Noseiden/Proyecto-SE/Hardware/Evidencia Fotográfica/Diseño PCB.png

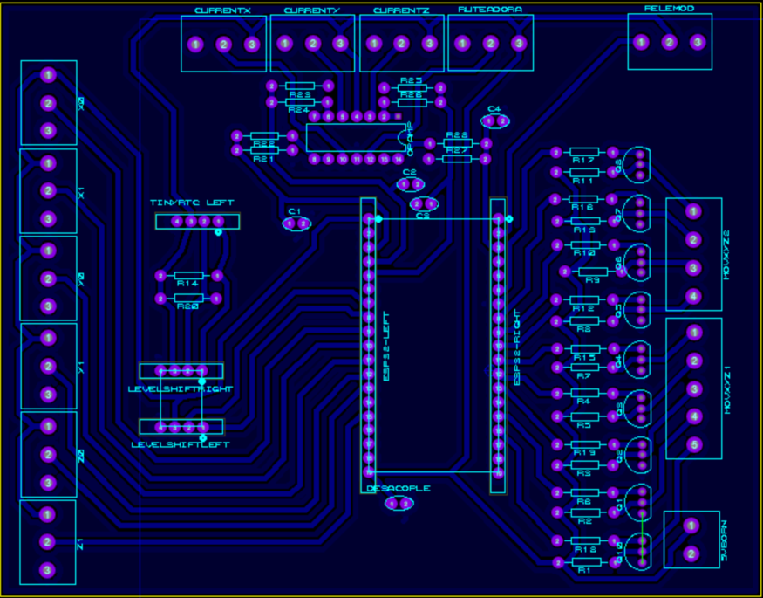
Hardware/Evidencia Fotográfica/Diseño PCB.png
