Noseiden/Proyecto-SE/Hardware/Evidencia Fotográfica/Conexiones en Gabinete.jpg

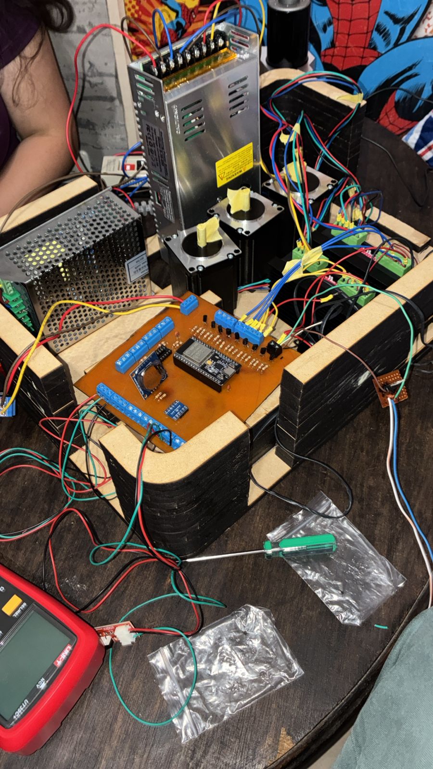
Hardware/Evidencia Fotográfica/Conexiones en Gabinete.jpg
