Noseiden/Proyecto-SE/Docs/DiagramaBloques.pdf

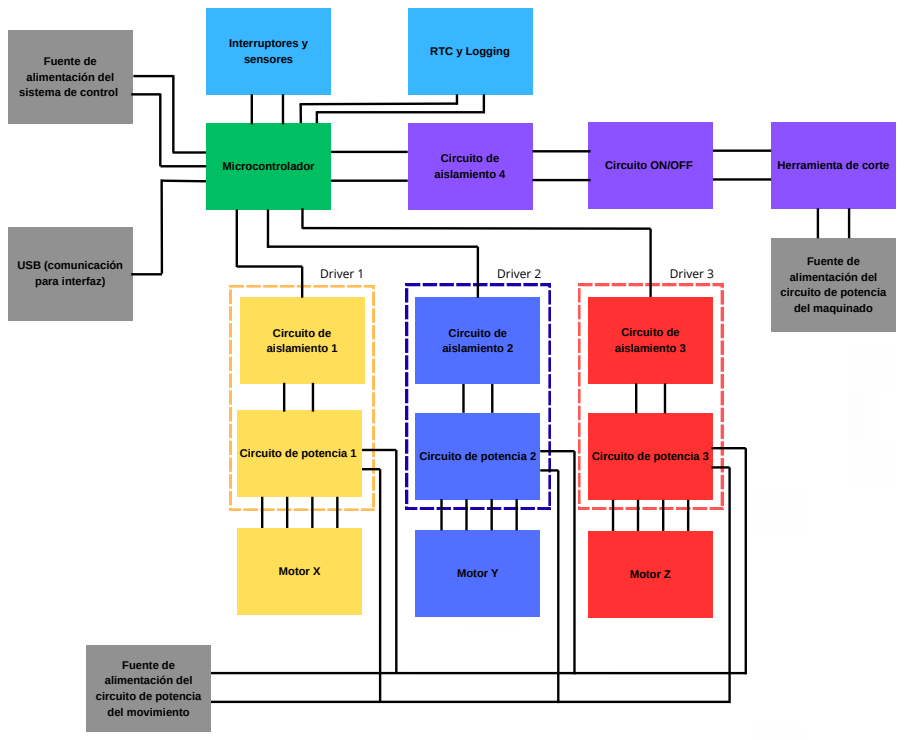
[picture p4: page 1]

USB (comunicación
para interfaz)

Microcontrolador

Circuito de
aislamiento 4
Circuito ON/OFF | Herramienta de corte

Circuito de
aislamiento 1

Circuito de
aislamiento 2

Circuito de
aislamiento 3
Circuito de potencia 1 | Circuito de potencia 2 | Circuito de potencia 3
Motor X | Motor Y | Motor Z

Fuente de
alimentación del
circuito de potencia
del movimiento

Fuente de
alimentación del
circuito de potencia
del maquinado
Driver 1 | Driver 2 | Driver 3

Interruptores y
Fuente de | sensores
alimentación del
sistema de control

RTC y Logging
