Noseiden/Proyecto-SE/Docs/REQUISITOS FUNCIONALES.pdf

REQUISITOS FUNCIONALES

### 1. Movimiento y funcionalidad

- TC-001: Movimiento traslacional de la herramienta (3 grados de libertad o DoF). Permiten el desplazamiento de la herramienta en los ejes X, Y y Z de forma independiente, lo cual es necesario para realizar mecanizado básico en tres dimensiones.
- TC-002: Movimiento rotativo de la herramienta. Permite el movimiento rotacional de la herramienta, responsable del mecanizado.
- TC-003: Alimentación externa fija. Garantiza una fuente de energía estable para el funcionamiento continuo del sistema.
- TC-004: Soporte estructural del sistema. Proporciona rigidez y estabilidad a todos los componentes de la máquina, asegurando la correcta alineación de los ejes y la herramienta, y minimizando vibraciones que puedan afectar la precisión del proceso de mecanizado.

### 2. Operación de la máquina (interfaz de usuario)

- TC-005: Control de encendido y apagado. Permite gestionar el estado operativo de la máquina de forma segura, evitando arranques y detenciones inesperadas.
- TC-006: Control programado de la posición de la herramienta. Garantiza que la herramienta siga trayectorias definidas, lo que es fundamental para lograr precisión en el proceso de corte.
- TC-007: Control manual y establecimiento del punto de origen. Permite al usuario posicionar la máquina manualmente y definir referencias iniciales necesarias para el mecanizado.

### 3. Sistema de emergencia

- TC-008: Detección de errores en el movimiento de los motores. Permite identificar fallas en la posición de la herramienta debido a la perdida de pasos u otros factores por definir
- TC-009: Detección de consumo anómalo de corriente. Permite detectar anomalías en el motor responsable del accionamiento de la herramienta.
- TC-010: Generación de alertas o retroalimentación al usuario. Facilita la interacción con el sistema mediante indicadores de estado (encendido, apagado, cortando, no cortando) y de los errores.

### 4. Monitoreo

- TC-011: Logging. Permite registrar eventos relevantes clasificadas por niveles de severidad, como errores estructurados, facilitando el análisis y la depuración del sistema.

REQUISITOS NO FUNCIONALES

- TC-012: Protocolo de comunicación. Define cómo se intercambia información entre los módulos del sistema, asegurando una comunicación confiable y estructurada.

- TC-013: Precisión (±1 mm). Establece el nivel de exactitud esperado en el posicionamiento, acorde al tipo de prototipo desarrollado.
- TC-014: Seguridad. El sistema debe detectar fallas y ejecutar acciones como el apagado controlado para evitar riesgos operativos.
- TC-015: Mantenibilidad. El diseño debe permitir un fácil acceso a componentes, facilitando reparaciones y modificaciones.
- TC-016: Interfaz intuitiva. Debe permitir que el usuario comprenda rápidamente el estado y control del sistema.
- TC-017: Fiabilidad. El sistema debe operar de forma estable, detectando y reportando errores para evitar fallos silenciosos.

PLAN DE TESTING:

### 1. Objetivo

- Verificar que la CNC cumple los requisitos funcionales y no funcionales, a través de pruebas definidas.

### 2. Alcance

Incluye: Verificación y funcionamiento de lo siguiente:

- Movimiento 3 ejes (Jog o movimiento manual de los ejes, homing o retorno a posición inicial, ejecutar trayectorias simples).
- Paro seguro por: ALM/following error, pico/sobrecorriente sostenida, limit switch, falla de comunicación.
- Control de ruteadora (ON/OFF).
- Telemetría/GUI
- Sistema de logging.

Excluye:

- Precisión industrial.
- Control de velocidad de spindle.
- Compensación de backlash.
- Validación metrológica.

### 3. Estrategia

- Pruebas unitarias: Lectura sensor corriente, lectura ALM, log format.
- Pruebas de integración: sensor + firmware + reacción (paro seguro).
- Pruebas de sistema: ejecutar una tarea completa y validar comportamiento.
- Pruebas de aceptación: Forzar errores que deshabiliten el sistema y demuestren

### 4. Herramientas

- Hardware:

- ESP32.
- Drivers/servos.
- Fuente 24V.
- Convertidor de 24V - 5V & 5V - 3.3V.
- Sensor corriente.
- Finales de carrera.
- Instrumentación:
- Multímetro.
- Pinza amperimétrica.
- Osciloscopio.
- Computador con la GUI.
- Carga mecánica controlada para emular situaciones adversas.

### 5. Consideraciones

Pre-testing

- La CNC hace homing y Jog básico.
- Hay lectura estable de ALM & corriente.
- El paro seguro apaga spindle y deshabilita ejes.

Resultados

- Todos los tests críticos pasan.
- No hay fallas de seguridad sin controlar.
- Evidencias almacenadas.

### 6. Entregables

- Matriz de trazabilidad (Requisito → Caso de prueba → Evidencia).
- Resultados (Pass/Fail).
- Evidencias: logs serial, capturas de GUI, videos cortos, mediciones (corriente/RPM si aplica) y fotos del montaje.
