Noseiden/Proyecto-SE/Hardware/Evidencia Fotográfica/Frontal PCB .jpeg

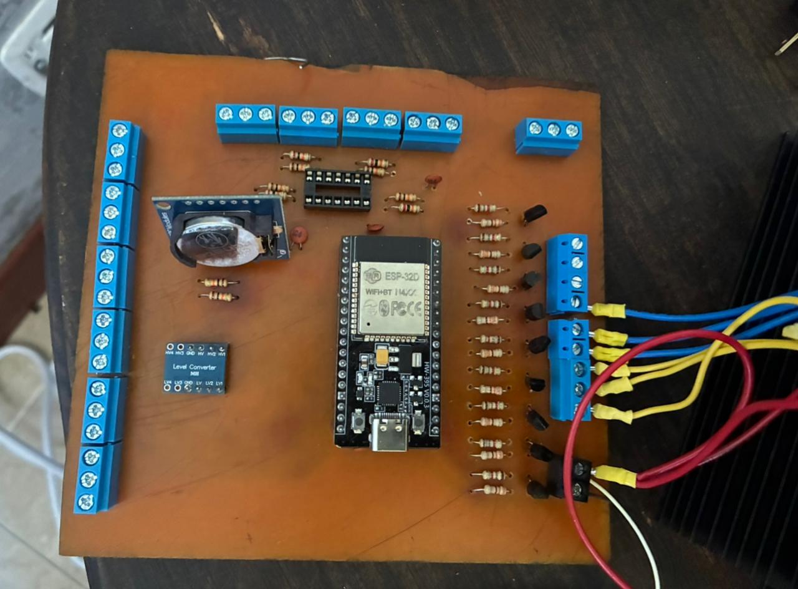
Hardware/Evidencia Fotográfica/Frontal PCB .jpeg
