Noseiden/Proyecto-SE/Hardware/Evidencia Fotográfica/Posterior PCB.jpeg

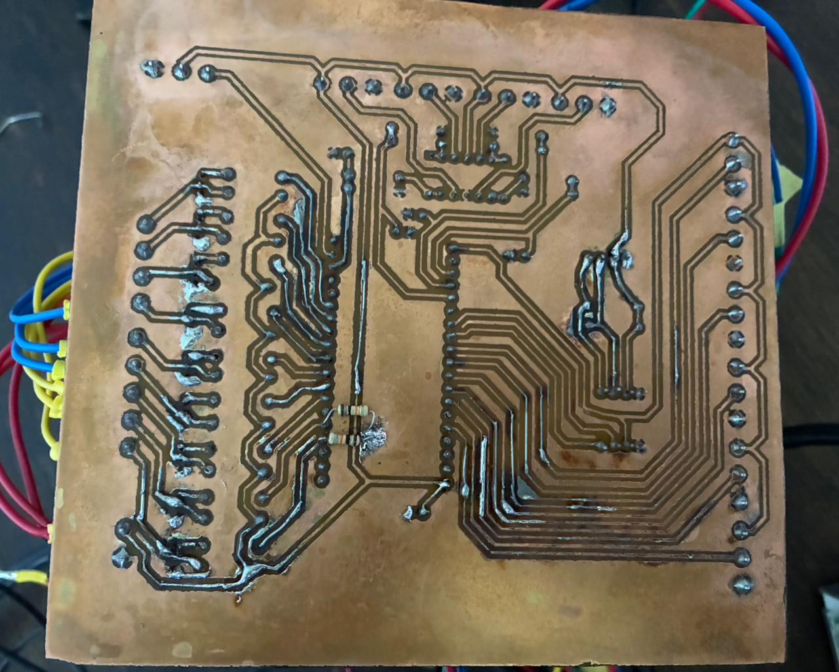
Hardware/Evidencia Fotográfica/Posterior PCB.jpeg
