Noseiden/Proyecto-SE/Hardware/Esquema_Electrico_Proyecto_Embebidos_2026_v1.PDF

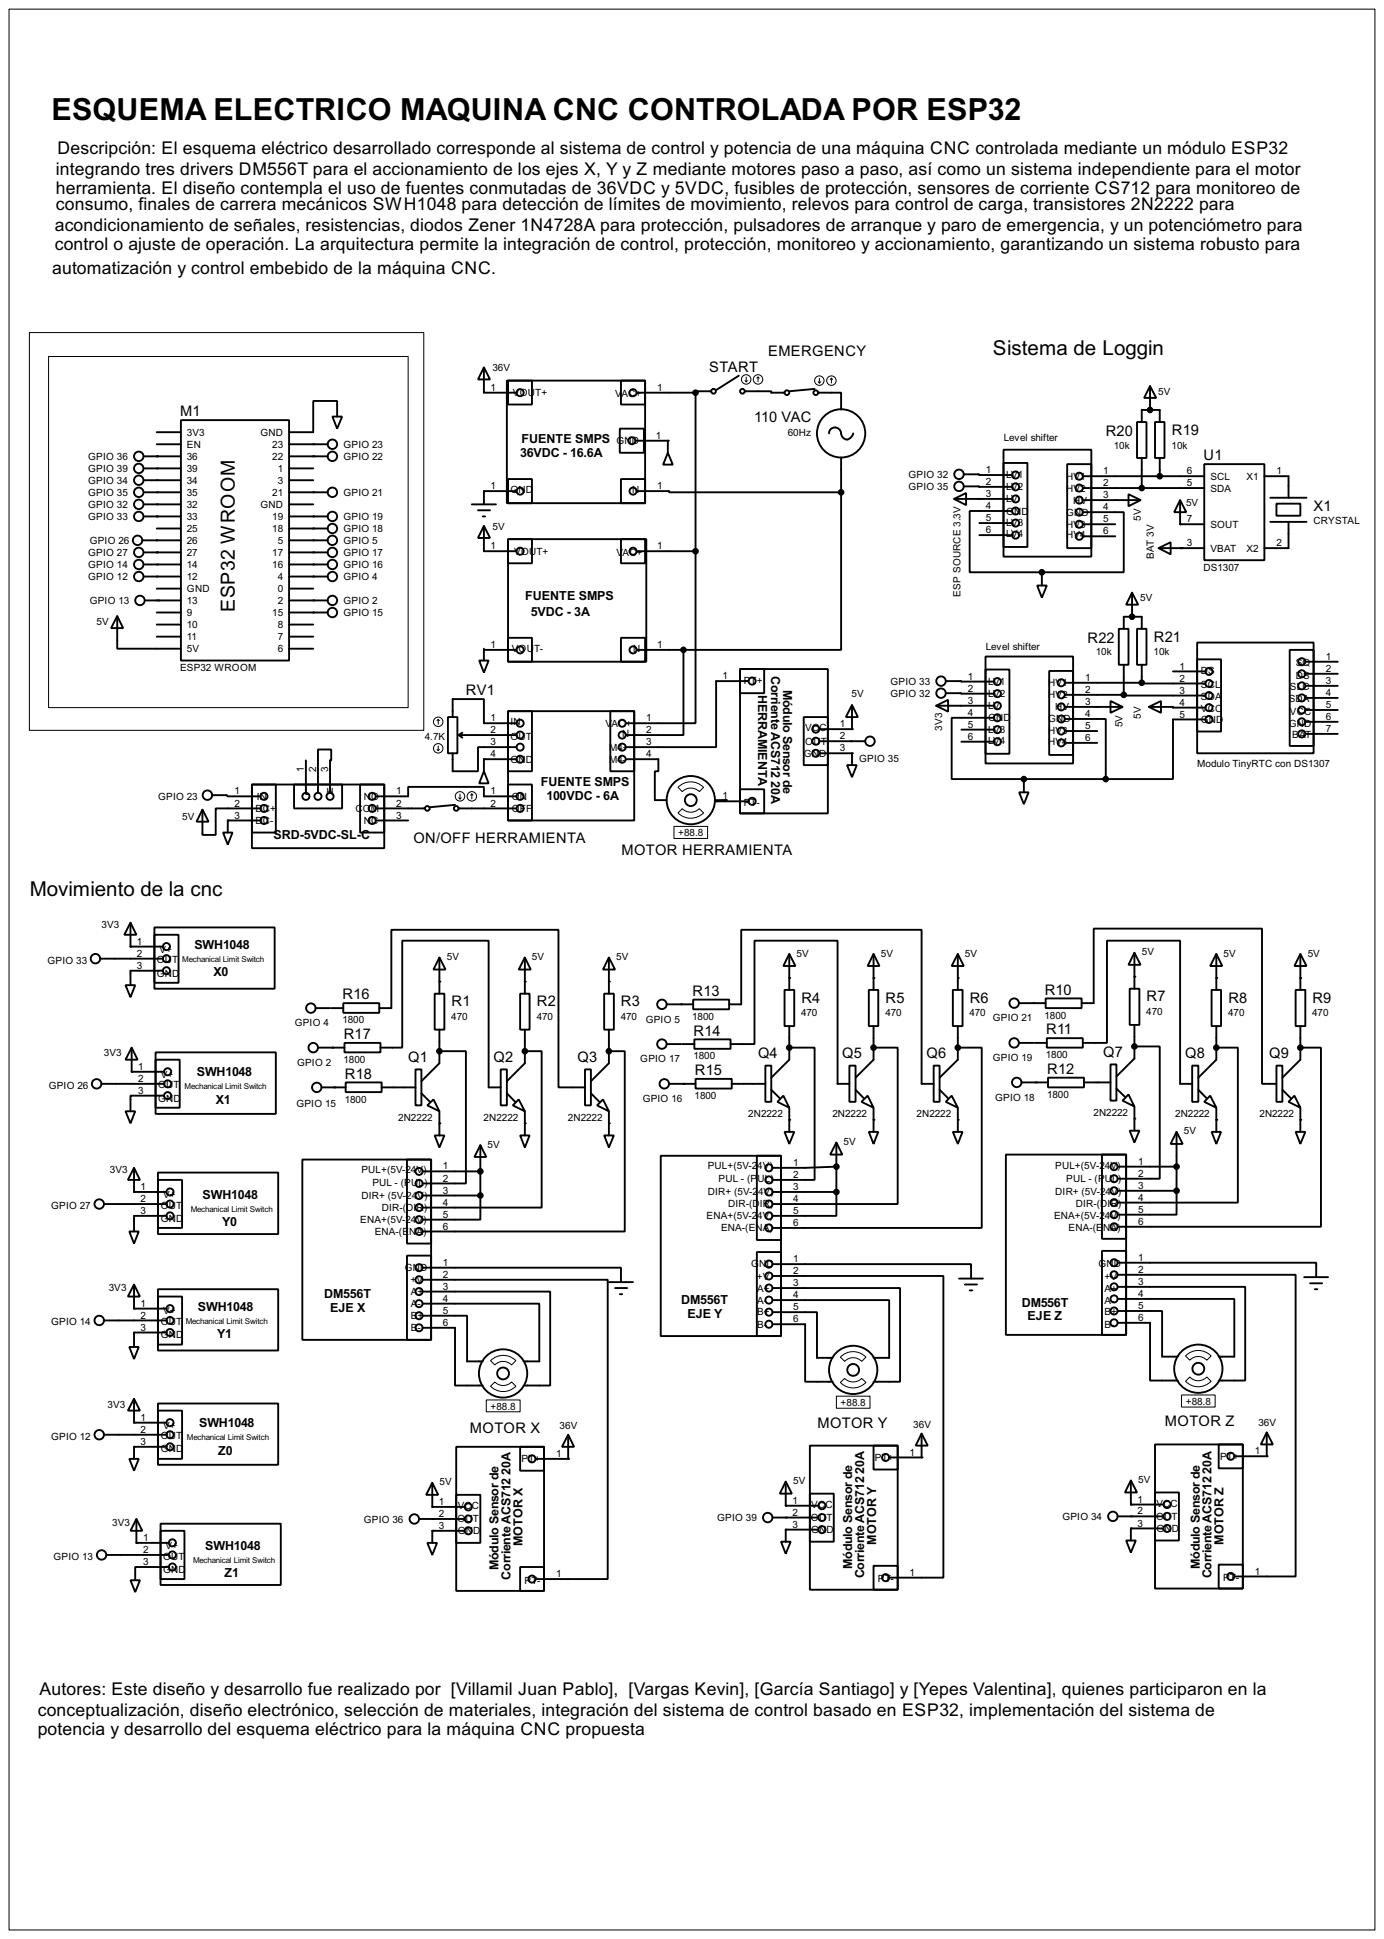
[picture p7: page 1]

ESQUEMA ELECTRICO MAQUINA CNC CONTROLADA POR ESP32

Descripción: El esquema eléctrico desarrollado corresponde al sistema de control y potencia de una máquina CNC controlada mediante un módulo ESP32
integrando tres drivers DM556T para el accionamiento de los ejes X, Y y Z mediante motores paso a paso, así como un sistema independiente para el motor
herramienta. El diseño contempla el uso de fuentes conmutadas de 36VDC y 5VDC, fusibles de protección, sensores de corriente CS712 para monitoreo de
consumo, finales de carrera mecánicos SWH1048 para detección de límites de movimiento, relevos para control de carga, transistores 2N2222 para
acondicionamiento de señales, resistencias, diodos Zener 1N4728A para protección, pulsadores de arranque y paro de emergencia, y un potenciómetro para
control o ajuste de operación. La arquitectura permite la integración de control, protección, monitoreo y accionamiento, garantizando un sistema robusto para
automatización y control embebido de la máquina CNC.

GPIO 32 GPIO 33 GPIO 27 GPIO 14 GPIO 12 GPIO 13

Módulo Sensor de Corriente A

Movimiento de la cnc

ENA-(ENA) ENA+(5V-24V) DIR-(DIR) DIR+ (5V-24V) PUL - (PUL) PUL+(5V-24V)

VCC OUT GND GPIO 39

VCC OUT GND GPIO 34

Autores: Este diseño y desarrollo fue realizado por [Villamil Juan Pablo], [Vargas Kevin], [García Santiago] y [Yepes Valentina], quienes participaron en la
conceptualización, diseño electrónico, selección de materiales, integración del sistema de control basado en ESP32, implementación del sistema de
potencia y desarrollo del esquema eléctrico para la máquina CNC propuesta
