Noseiden/Proyecto-SE/Hardware/Componentes/23HS32-4004S.pdf

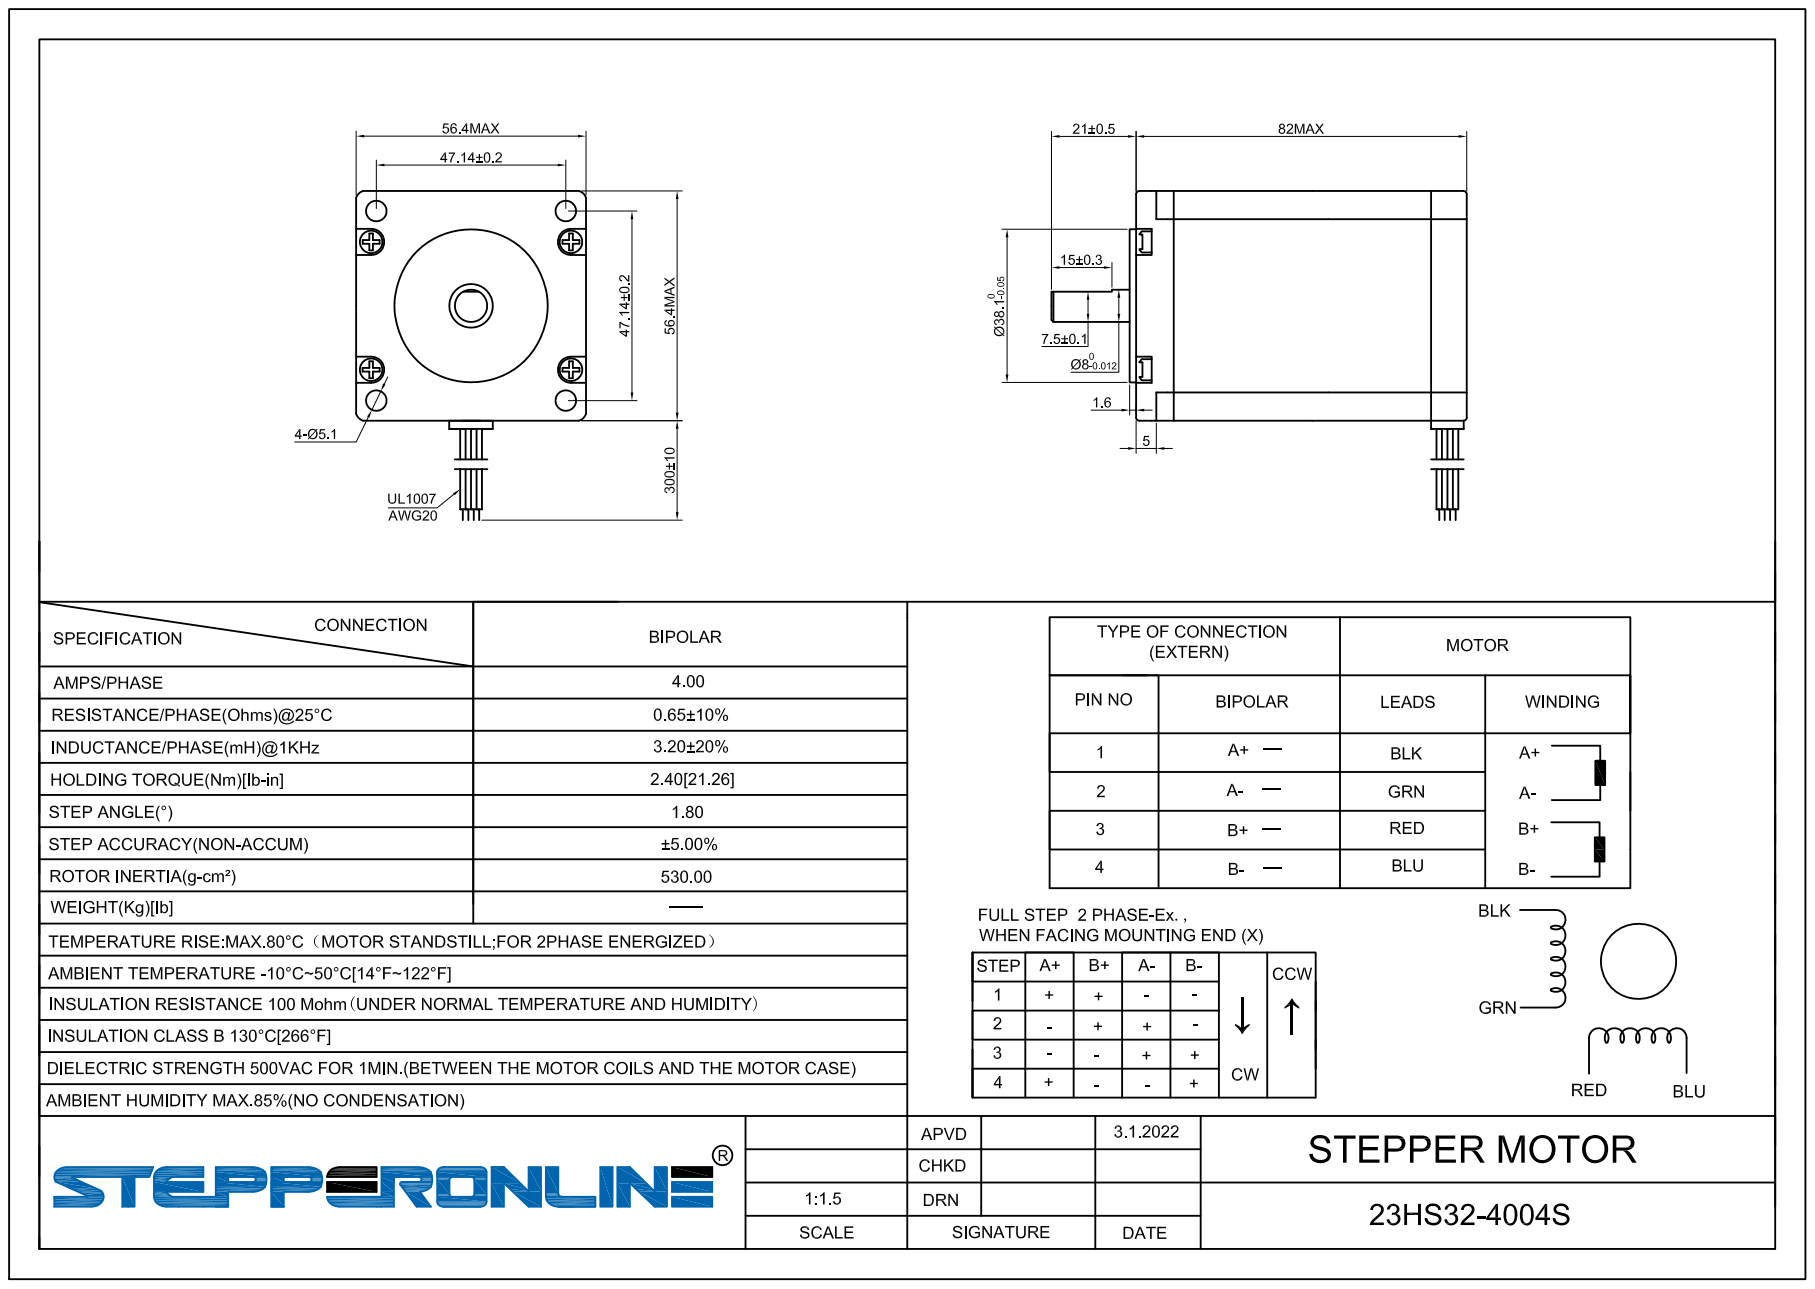
[picture p8: page 1]
