Noseiden/Proyecto-SE/(list of files, drawings)

Other design files:
Hardware/PCB Proteus/PCB_v_yepesitav2.pdsprj
