Noseiden/Proyecto-SE/Firmware_ESP32/ProyectoCNC/src/main.c

#include "system_lib.h" //Tiene librerías necesarias de C y PlatformIO, así como también los pines GPIO
#include "current_sensor.h"
#include "logging.h"
#include "motors.h"
#include "router_spindle.h"
#include "rtc_ds1307.h"

int step_mm = 1;
int step_received = 0;
TickType_t timestamp_alarm = 0;
bool to_shutdown_spindle = false;

typedef enum { //botones de GUI
    CMD_NONE, 
    CMD_START, 
    CMD_PAUSE, 
    CMD_STOP, 
    CMD_RESET, 
    CMD_JOG_XP,
    CMD_JOG_XM,
    CMD_JOG_YP,
    CMD_JOG_YM,
    CMD_JOG_ZP,
    CMD_JOG_ZM,
    CMD_JOG_RELEASED,
} gui_command_t;
volatile gui_command_t last_command = CMD_NONE; //volátil porque puede cambiar en interrupciones

typedef enum { //Estados
    STATE_INIT,
    STATE_IDLE,
    STATE_JOG,
    STATE_HOMING,
    STATE_RUNNING,
    STATE_PAUSE,
    STATE_ALARM
} cnc_state_t;
volatile cnc_state_t current_state = STATE_INIT;


bool direction_x = true, direction_y = true, direction_z = false; //CCW = true, CW = false
bool x_jog = false, y_jog = false, z_jog = false; 


void task_receive_gui(void *pvParameters){ //Recepción de botones de GUI para cambio de estado
    uint8_t data[128];
    while(1){
        int len = uart_read_bytes(UART_PORT, data, sizeof(data) - 1, 20 / portTICK_PERIOD_MS);
        if (len > 0) {
            data[len] = '\0'; // Convertimos a string de C
            char *p_step = strstr((char*)data, "STEP:");
            // Comparamos lo recibido con las palabras clave de botones
            if (p_step != NULL){
                if(sscanf(p_step, "STEP:%d", &step_mm) == 1){  // Con sscanf, busca en STEP: un número entero(%d) para llevarlo a step_mm
                    ds1307_read_time(0);
                    GUI_INFO("Paso de JOG actualizado a: %d mm/min", step_mm);
                }
            } else if (strstr((char*)data, "START"))  last_command = CMD_START;
            else if (strstr((char*)data, "PAUSE"))  last_command = CMD_PAUSE;
            else if (strstr((char*)data, "STOP"))   last_command = CMD_STOP;
            else if (strstr((char*)data, "RESET"))  last_command = CMD_RESET;
            else if (strstr((char*)data, "Zp"))     last_command = CMD_JOG_ZP;
            else if (strstr((char*)data, "Zm"))     last_command = CMD_JOG_ZM;
            else if (strstr((char*)data, "Xp"))     last_command = CMD_JOG_XP;
            else if (strstr((char*)data, "Xm"))     last_command = CMD_JOG_XM;
            else if (strstr((char*)data, "Yp"))     last_command = CMD_JOG_YP;
            else if (strstr((char*)data, "Ym"))     last_command = CMD_JOG_YM;
            else if (strstr((char*)data, "JOG_RELEASED")) last_command = CMD_JOG_RELEASED;
        }
        vTaskDelay(pdMS_TO_TICKS(10)); //Para evitar WatchDog
    }
}

void app_main(void) {
    uart_config_t uart_config = {
        .baud_rate = 115200,  
        .data_bits = UART_DATA_8_BITS,
        .parity = UART_PARITY_DISABLE,
        .stop_bits = UART_STOP_BITS_1,
        .flow_ctrl = UART_HW_FLOWCTRL_DISABLE,
        .source_clk = UART_SCLK_DEFAULT
    };
    uart_param_config(UART_PORT, &uart_config); // & para mandar de una vez como pointer
    uart_driver_install(UART_PORT, 1024, 1024, 0, NULL, 0);
    
    spindle_init(); // Configuración de la ruteadora
    motor_init(); // Configuración de los motores de los ejes y finales de carrera
    I_sensor_init(); //Configuración ADC de los sensores de corriente
    consumo_cnc_t corrientes_actuales;
    int adc_raw;
    cnc_state_t last_reported_state = -1;
    xTaskCreate(task_receive_gui, "GUI_Task", 4096, NULL, 5, NULL); //para que FreeRTOS identifique la tarea 
    i2c_init();
    ds1307_write_hours(0, 0, 9, 5, 29, 5, 26); // 09:00:00, día 5 de la semana, 29/05/26 
    current_state = STATE_IDLE;
    bool paused = false;
    while (1) {
        if (last_command != CMD_NONE) { //Las transiciones a cada estado por botones de GUI
            switch(last_command) {
                case CMD_START: current_state = STATE_RUNNING; break;
                case CMD_PAUSE: current_state = STATE_PAUSE; break;
                case CMD_RESET: current_state = STATE_HOMING; break;
                case CMD_STOP:  current_state = STATE_ALARM; break;
                case CMD_JOG_XP: 
                    if(current_state == STATE_IDLE) {
                        current_state = STATE_JOG; 
                        x_jog = true;
                        direction_x = true; 
                    }
                    break;
                case CMD_JOG_XM: 
                    if(current_state == STATE_IDLE) {
                        current_state = STATE_JOG; 
                        x_jog = true;
                        direction_x = false; 
                    }
                    break;
                case CMD_JOG_YP: 
                    if(current_state == STATE_IDLE) {
                        current_state = STATE_JOG; 
                        y_jog = true;
                        direction_y = true; 
                    }
                    break;
                case CMD_JOG_YM: 
                    if(current_state == STATE_IDLE) {
                        current_state = STATE_JOG; 
                        y_jog = true;
                        direction_y = false; 
                    }
                    break;
                case CMD_JOG_ZP: 
                    if(current_state == STATE_IDLE) {
                        current_state = STATE_JOG; 
                        z_jog = true;
                        direction_z = false; 
                    }
                    break;
                case CMD_JOG_ZM: 
                    if(current_state == STATE_IDLE) {
                        current_state = STATE_JOG; 
                        z_jog = true;
                        direction_z = true; 
                    }
                    break;
                case CMD_JOG_RELEASED:
                    if(current_state == STATE_JOG) {
                        stop_motors(); // Usamos tu función existente para apagar los PWM
                        x_jog = false;
                        y_jog = false;
                        z_jog = false;
                        current_state = STATE_IDLE; 
                    }
                    break;
                default: // Por seguridad, siempre es bueno tener un default
                    break;
            }
            last_command = CMD_NONE; //Reset del comando después de procesarlo
        }

        if (current_state != last_reported_state){ //Para enviar los mensajes de logging una vez se ha cambiado de estado
            switch (current_state) { //Lo que hace cada estado
                case STATE_IDLE:
                    ds1307_read_time(0);
                    GUI_INFO("Esperando órdenes o movimiento manual");
                    SPINDLE_OFF;
                    paused = false;
                    break;

                case STATE_JOG:
                    SPINDLE_OFF;
                    motor_jog(step_mm, direction_x, direction_y, direction_z, x_jog, y_jog, z_jog);
                    break;
                case STATE_HOMING:
                    ds1307_read_time(0);
                    GUI_INFO("Retorno a posición inicial");
                    ds1307_read_time(1);
                    GUI_WARN("Primero eje Z, luego X y Y");
                    home(true);
                    break;

                case STATE_RUNNING:
                    ds1307_read_time(0);
                    GUI_INFO("En proceso de maquinado...");
                    SPINDLE_ON;
                    ds1307_read_time(1);
                    GUI_WARN("Despeje la zona");
                    x_jog = false;
                    y_jog = false;
                    z_jog = false;
                    if(paused == false){
                        make_a_circle(true, false, -1);
                    } else{
                        make_a_circle(true, true, segment);
                    }
                    break;

                case STATE_PAUSE:
                    ds1307_read_time(0);
                    GUI_INFO("Continuar el proceso presionando Start");
                    ds1307_read_time(1);
                    GUI_WARN("Spindle aún encendido");
                    SPINDLE_ON;
                    paused = true;
                    stop_motors();
                    break;

                case STATE_ALARM:
                    ds1307_read_time(0);
                    GUI_INFO("Proceso detenido completamente");
                    ds1307_read_time(1);
                    GUI_WARN("Pérdida de pasos");
                    stop_motors();
                    timestamp_alarm = xTaskGetTickCount(); //Inicia tiempo para Spindle
                    to_shutdown_spindle = true;
                    break;
                default: //Por seguridad
                    break; 
            }
            last_reported_state = current_state; //Guardamos el estado actual
        }
        switch(current_state){ //Acciones continuas mientras se esté en el estado
            case STATE_JOG:
                if(x_jog){
                    if((SWITCH_X1_ON && direction_x) || (SWITCH_X0_ON && direction_x == false)){ //Prevención para no superar límites de máquina
                        ds1307_read_time(2);
                        GUI_ERROR("Pasó el límite del área de trabajo");
                        ledc_set_duty(LEDC_LOW_SPEED_MODE, LEDC_CHANNEL_0, 0);
                        ledc_update_duty(LEDC_LOW_SPEED_MODE, LEDC_CHANNEL_0);
                        MOTOR_X_DISABLED;
                        current_state = STATE_IDLE;
                    }
                }
                if(y_jog){
                    if((SWITCH_Y1_ON && direction_y) || (SWITCH_Y0_ON && direction_y == false)){ //Prevención para no superar límites de máquina
                        ds1307_read_time(2);
                        GUI_ERROR("Pasó el límite del área de trabajo");
                        ledc_set_duty(LEDC_LOW_SPEED_MODE, LEDC_CHANNEL_1, 0);
                        ledc_update_duty(LEDC_LOW_SPEED_MODE, LEDC_CHANNEL_1);
                        MOTOR_Y_DISABLED;
                        current_state = STATE_IDLE;
                    }
                }
                if(z_jog){
                    if((SWITCH_Z0_ON && direction_z) || (SWITCH_Z1_ON && direction_z == false)){ //Prevención para no superar límites de máquina
                        ds1307_read_time(2);
                        GUI_ERROR("Pasó el límite del área de trabajo");
                        ledc_set_duty(LEDC_LOW_SPEED_MODE, LEDC_CHANNEL_2, 0);
                        ledc_update_duty(LEDC_LOW_SPEED_MODE, LEDC_CHANNEL_2);
                        MOTOR_Z_DISABLED;
                        current_state = STATE_IDLE;
                    }
                }
                break;
            case STATE_HOMING:
                if(home(false) == true){
                    current_state = STATE_IDLE;
                }
                if(SWITCH_Z1_OFF){ //Si el sensor Z1 se deja de presionar, los motores X y Y no se moverán más
                    ledc_set_duty(LEDC_LOW_SPEED_MODE, LEDC_CHANNEL_0, 0);
                    ledc_update_duty(LEDC_LOW_SPEED_MODE, LEDC_CHANNEL_0);
                    ledc_set_duty(LEDC_LOW_SPEED_MODE, LEDC_CHANNEL_1, 0);
                    ledc_update_duty(LEDC_LOW_SPEED_MODE, LEDC_CHANNEL_1);
                }
                break;
            case STATE_RUNNING:
                if(make_a_circle(false, false, -1) == true){
                    ds1307_read_time(0);
                    GUI_INFO("Maquinado de la figura completado");
                    current_state = STATE_IDLE;
                }
                adc_oneshot_read(adc1_handle, ADC_CHANNEL_7, &adc_raw); 
                corrientes_actuales.s_I = calc_I(adc_raw); 
                adc_oneshot_read(adc1_handle, ADC_CHANNEL_0, &adc_raw); 
                corrientes_actuales.x_I = calc_I(adc_raw); 
                adc_oneshot_read(adc1_handle, ADC_CHANNEL_3, &adc_raw);
                corrientes_actuales.y_I = calc_I(adc_raw);
                adc_oneshot_read(adc1_handle, ADC_CHANNEL_6, &adc_raw);
                corrientes_actuales.z_I = calc_I(adc_raw);

                if (corrientes_actuales.s_I > 2.50f) {
                    ds1307_read_time(2);
                    GUI_ERROR("Sobrecarga en la Ruteadora: %.2f A", corrientes_actuales.s_I);
                    current_state = STATE_ALARM;
                } else if (corrientes_actuales.x_I > 4){
                    ds1307_read_time(2);
                    GUI_ERROR("Sobrecarga en el motor X: %.2f A", corrientes_actuales.x_I);
                    current_state = STATE_ALARM;
                } else if (corrientes_actuales.y_I > 4){
                    ds1307_read_time(2);
                    GUI_ERROR("Sobrecarga en el motor Y: %.2f A", corrientes_actuales.y_I);
                    current_state = STATE_ALARM;
                } else if (corrientes_actuales.z_I > 4){
                    ds1307_read_time(2);
                    GUI_ERROR("Sobrecarga en el motor Z: %.2f A", corrientes_actuales.z_I);
                    current_state = STATE_ALARM;
                }
                if (SWITCH_X1_ON || SWITCH_Y1_ON || SWITCH_Z1_ON ||
                    SWITCH_X0_ON || SWITCH_Y0_ON || SWITCH_Z0_ON){
                    //La anterior condición solo funciona adecuadamente si se mueven los motores de las esquinas al iniciar
                    ds1307_read_time(2);
                    GUI_ERROR("Pasó el límite del área de trabajo");
                    current_state = STATE_ALARM;
                }
                break;
            case STATE_ALARM:
                if (to_shutdown_spindle){
                    if ((xTaskGetTickCount() - timestamp_alarm) >= pdMS_TO_TICKS(2000)){ // Control por Marca de Tiempo (Timestamp Polling).
                        SPINDLE_OFF;
                        to_shutdown_spindle = false;
                        ds1307_read_time(0);
                        GUI_INFO("Ruteadora apagada por seguridad tras 2s");
                        current_state = STATE_IDLE;
                    }
                }  
                break;
            default:
                break;
        }
        
        vTaskDelay(pdMS_TO_TICKS(20)); // Pequeña espera para no saturar CPU y t<mbién muestreo de ADC
    }
}
