Noseiden/Proyecto-SE/Firmware_ESP32/ProyectoCNC/include/system_lib.h

#pragma once
#include <math.h>
#include <stdint.h>
#include <string.h> //para los caracteres
#include <stdio.h>
#include <stdarg.h> //Para el logging
#include <stdlib.h> //Para atoi() --> ASCII to integer
#include <inttypes.h>
#include "freertos/FreeRTOS.h"
#include "freertos/task.h"
#include "driver/gpio.h"
#include "driver/timer.h"
#include "esp_adc/adc_oneshot.h" //ADC
#include "driver/ledc.h" //PWM
#include "driver/uart.h" //Comunicación serial UART
#include "driver/i2c.h"

#include "pin_map.h"
