Noseiden/Proyecto-SE/(commit log)

2026-03-28 Requisitos y test case
2026-04-18 Diagrama de Bloques del sistema
2026-04-18 Detalles de componentes
2026-05-02 Adición bloque para Logging
2026-05-03 Recepción de los botones para la máquina de estados
2026-05-03 Identificación de header files
2026-05-03 Adición de system_lib y comienzo de lectura sensores
2026-05-04 Recepción de mensajes de Logging desde C
2026-05-04 Código para enviar mensajes de Logging y configuración del sensor
2026-05-06 Toma de datos del sensor y su cambio de estado
2026-05-08 Cambio en pines para mejor implementación en PCB
2026-05-09 Cambio en pines ADCs para mejor implementación en PCB
2026-05-14 Cambio en pines GPIO IN/OUT para comunicación I2C
2026-05-17 Implementación código de clase DS1307 en interfaz
2026-05-17 Control por marca de tiempo, acciones continuas para estados y Spindle ON/OFF
2026-05-18 Configuración inicial para el driver DM556 de los motores de cada eje
2026-05-18 Cambio unidades para step
2026-05-18 Función para movimiento manual (Jog) de los motores de los ejes
2026-05-18 Adición de estado Homing con su respectiva función
2026-05-18 Movimiento de ejes X y Y para hacer un círculo
2026-05-18 Correcciones para implementación
2026-05-19 Video inicial para la interfaz
2026-05-19 Adición del video a la interfaz y en bucle
2026-05-20 Recordar cambiar las rutas de app.log en logger.py y el video.mp4 en gui.py al ejecutar el programa
2026-05-21 Cambio en la frecuencia y velocidad del PWM enviado a motores de los ejes
2026-05-23 Cambio de Incremental Jogging a Continuous Jogging
2026-05-23 Corrección en ENA para motores de los ejes y función bcd2decimal para RTC
2026-05-25 Correcciones en cuanto a conservar la posición inicial después de Pause
2026-05-25 Se descarta el botón de Origen por tener un movimiento predeterminado para START
2026-05-25 Corrección para condición del sensor de corriente y muestreo con el while para ADC
2026-05-25 Nueva forma de mostrar los mensajes Logging en GUI y variable externa para usar ADC en main.c
2026-05-26 Tercera versión del test case con avances
    :3
2026-05-26 Archivo CAD de la CNC
2026-05-26 Primera versión de evidencias del test case
2026-05-26 Delete Docs/Test Case.pdf
    Version antigua
2026-05-26 STRM del proyecto
    [SRTM_Proyecto_CNC.xlsx]
2026-05-26 Delete Docs/Plantilla Test Case.pdf
    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
2026-05-26 Evidencia fotográfica de CNC y Archivos de diseño PCB
    [PCB_v_yepesitav2.pdsprj]
2026-05-26 Precaución agregada para el movimiento manual o Jogging
2026-05-29 Corrección en parada por sensores en Jog
2026-05-29 Corrección posición inicial Z en Homing
2026-05-29 Punto de partida de 300 mm/min para Jog
2026-05-29 Condición de seguridad con Z1 para Homing
2026-05-29 Mayor frecuencia y tiempo en el segmento del círculo
2026-05-30 Test case y SRTM
    Cuarta version del test case y segunda version del SRTM
    [SRTM_Proyecto_CNC.xlsx]
